DavidW-evoSonic/ESP32_ReflowOvenController/00081-01-L.jpg

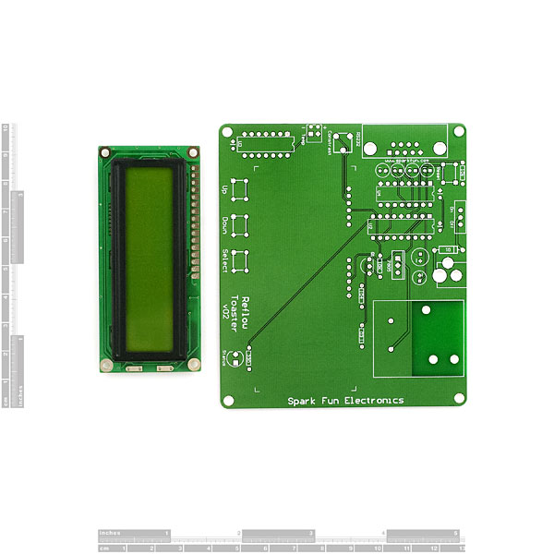
00081-01-L.jpg
