DavidW-evoSonic/ESP32_ReflowOvenController/00081-02-L.jpg

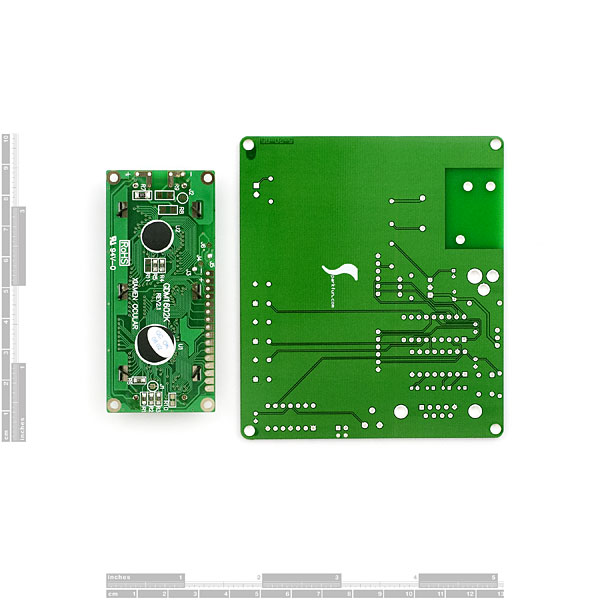
00081-02-L.jpg
