DavidW-evoSonic/ESP32_ReflowOvenController/00081-05-L.jpg

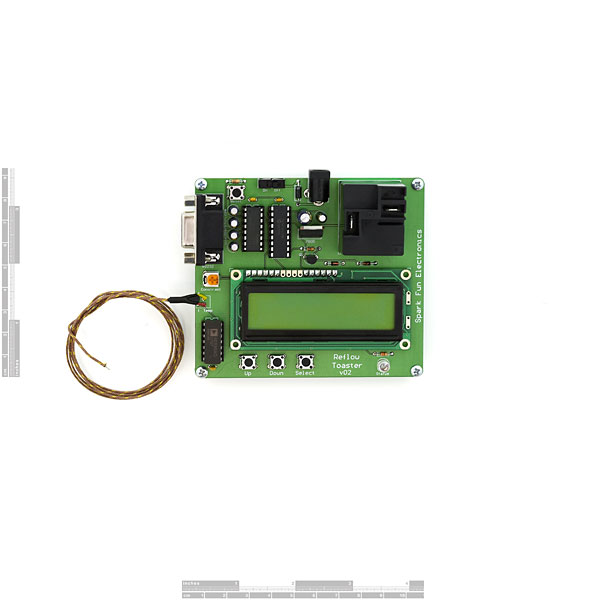
00081-05-L.jpg
