DavidW-evoSonic/ESP32_ReflowOvenController/(commit log)

2019-06-15 More Bug fixing and less agressive PID Tuning
    [ReflowController.ino]
2026-09-02 Replace phase-fired output stage with time-proportional relay control
    The reworked hardware has a mechanical relay and no zero-crossing detect
    input, so phase-angle firing is not possible. Removed the zero-cross ISR,
    the edge-timing/jitter validation in loop(), the one-shot scheduling in
    switchPower(), and the asin lookup table that linearised phase angle to
    power.
    In their place relayDriver() runs from a periodic esp_timer and expresses
    PID demand as on-time within a fixed 4s window, latched once per window so
    the on-pulse stays contiguous. Min on/off clamps round sub-500ms pulses
    away to fully off or fully on rather than cycling the contacts for them.
    HEATER1/HEATER2 collapse to a single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
    [ReflowController.ino]
2026-09-02 Read temperature from AD595 on ADC1 instead of MAX31855 over SPI
    The reworked hardware has an AD595 (10 mV/degC) on an analog pin rather
    than a MAX31855 on SPI. readTemperature() oversamples ADC1 64x to knock
    down the ESP32's sample noise and converts via esp_adc_cal, so the result
    uses the chip's factory eFuse calibration rather than a nominal full
    scale. Channel 6 (GPIO34) is input-only, and on ADC1 because ADC2 is
    unusable while WiFi is up.
    The signal is divided 1.5:1 in hardware before reaching the pin. The ADC
    is specified linear only to ~2450mV, so undivided, 250degC (2.50V at
    10mV/degC) would sit against the ceiling, compressed and reading low --
    the unsafe direction, since the PID w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
    [ReflowController.ino]
2026-09-02 Strip the display UI and drive the oven headlessly
    The reworked hardware has no TFT and no rotary encoder, so the display
    stack goes: Adafruit_GFX/ST7735, the menu engine and its whole MenuItem
    table, the on-screen keyboard, ClickEncoder, and every render path
    (renderMenuItem, updateProcessDisplay, splashscreen, memoryFeedbackScreen,
    displayMenusInfos). The RGB LED and buzzer stay -- they are local
    feedback rather than display, and on an oven with no screen they are the
    only indication you get without a browser.
    currentState was doing two jobs, mixing menu states with process states.
    Idle/Settings/Edit are replaced by Ready and Manual, and UIMenuEnd is
    renamed ProcessStart to say what the c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
    [ReflowController.ino]
2026-09-02 Provision WiFi through WiFiManager instead of the encoder
    Provisioning was an encoder-driven network scan with an on-screen
    keyboard, which the display rework left unreachable. WiFiManager raises
    its own access point when it has no working credentials, so the oven is
    set up from a phone through the captive portal instead.
    The portal is given a 180s timeout rather than being left open
    indefinitely: with no display there is nothing to show that the oven is
    sitting in the portal, and loop() has a relay and a sensor to service.
    Since there is no longer any local input, factoryReset also drops the
    WiFi credentials -- otherwise moving the oven to a different network
    would leave no way back to th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
    [ReflowController.ino]
2026-09-02 Surface profile, PID and autotune settings to the web UI
    Profile slots, profile fields, PID gains and the autotune parameters were
    all edited through the rotary-encoder menu, so the display rework left
    them with no way in. They are now readable at /profiles and /config and
    writable through /profile/edit, /pid and /tuning, with a settings panel
    in the browser UI covering the slot picker, the profile fields, PID, the
    autotune parameters, manual heating and factory reset.
    Editing follows the menu's old semantics: /profile/edit changes only the
    in-memory profile, and nothing is persisted until a slot is chosen via
    /profile/save. Mutations are refused with 409 unless the oven is idle.
    Writes ap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
    [ReflowController.ino]
2026-09-02 Replace PID with rate-corridor control
    The PID gains were never right for this hardware -- Kp 0.60 / Ki 0.01 /
    Kd 19.70 were tuned against a continuously-variable phase-fired SSR and the
    actuator is now a mechanical relay -- and they had never controlled anything on
    this branch. The rate-corridor law from the earlier C# controller had, on this
    oven, this relay and this probe. So the unproven component was PID, not the
    corridor law, and the swap removes an unknown rather than adding one.
    A profile is now a list of steps, each "reach targetTemp in between minDuration
    and maxDuration seconds". That pair is a corridor rather than a setpoint, and
    the controller nudges a discrete power level by o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
    [ReflowController.ino]
2026-09-02 Hold the relay off unless the control loop is alive
    relayDriver() runs from an esp_timer so it keeps servicing the relay when
    loop() blocks, which REWORK_NOTES sold as a feature. It is also the failure
    mode: loop() is the only thing that ever *lowers* powerHeater, so a stall in
    the web server or the WiFi stack leaves the timer driving the element at the
    last demand for as long as the board stays powered. On a mains heater that is
    the one bug that does not end with a wasted board.
    The control loop now stamps a heartbeat every 100 ms and relayDriver() refuses
    to close the relay without a fresh one. Two thresholds, because a transient
    stall and a dead loop() want different answers: stale by 5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
    [ReflowController.ino]
2026-09-02 Fix the temperature acquisition path for hum and resolution
    Two defects in readTemperature(), both of which mattered little under PID and
    matter a lot now that the controller steers a projection. The rate term is a
    difference of two rolling averages, and the projection multiplies it by the
    thermal lag before comparing it to a step target, so anything that corrupts the
    reading is amplified ten- or twentyfold into a decision about when to stop
    driving the element.
    Mains hum was passing through essentially unattenuated. The 64 oversamples were
    taken back to back, spanning about a millisecond -- a twentieth of a 50 Hz
    cycle -- so every sample landed on the same part of the sine wave and the
    ave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
    [ReflowController.ino]
2026-09-02 Defer the door prompt to the peak, and lock out a warm start
    Two ways the firmware could behave exactly as designed and still produce an
    unacceptable board.
    The door-open prompt fired before the peak. A heating step ends when arrival is
    *projected*, which is deliberately while the oven is still climbing and short
    of target -- the stored heat delivers the rest. Entering the next step is what
    beeped, so the firmware asked for the door at the exact moment the coast was
    doing the work of reaching peak temperature. Simulated, the prompt fired at
    236.6 degC with the 243.7 degC peak still 9 s away: an operator standing ready
    took 7 degC off the peak and shortened time above liquidus, with a perfec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
    [ReflowController.ino]
2026-09-02 Let each step choose whether its bounds are durations or rates
    Corridors rebase on the measured temperature at step entry, so a step whose
    bounds are durations covers less ground when the chamber starts warm while
    still taking its allotted time -- the ramp flattens, and spends longer drying
    the flux out before the board reaches liquidus. No fault, and a log that looks
    perfect. Locking out a warm start bounded that; it did not fix it.
    Steps now carry a BOUND_RATE flag and may state their pair as degC/s instead
    of seconds, with deriveStepDurations() converting via the distance the step
    actually has to cover. Which invariant is correct genuinely differs by step,
    which is why it is per-step rat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
    [ReflowController.ino]
2026-09-02 Pre-flash fixes: heater on GPIO 16, temperature filters primed
    Two things found on a last read-through before the firmware meets an oven.
    The heater pin is decided. 16 is one of the two original heater pins and so is
    already routed for heater duty on the board, which makes it the obvious choice;
    17 stays free as the alternative. The define is no longer a placeholder and the
    TODO goes with it, taking the relay GPIO off the blocker list in REWORK_NOTES
    section 1 -- two remain, the divider and the board type.
    Two hardware assumptions ride on that pin, neither of which the firmware can
    check for itself. GPIO 16 and 17 are the PSRAM interface on WROVER modules, so
    this assumes a plain WROOM, as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
    [ReflowController.ino]
2026-09-03 Initialise the LEDC buzzer channel, not just its timer
    ledcSetup(0,1000,0) passed 0 as duty resolution, which is out of range, so
    it configured nothing. ledcSetup only sets up the timer in any case, leaving
    ledcAttachPin to read back an unconfigured channel.
    [ReflowController.ino]
2026-09-03 Show live temperature, target and heater state above the graph
    The heater tile reports the relay contact, not the demand: the two differ
    whenever a fault or a stale heartbeat holds the relay off, and constantly
    during normal running.
    Target blanks when idle, because the Ready state parks the setpoint on the
    current temperature, which is not an intention the oven has. The readout
    greys out on a failed poll rather than showing a stale number confidently.
    [ReflowController.ino]
2026-09-03 Apply the step's fast rate bound in every corridor branch
    It lived in the inside-the-corridor arm, which is unreachable once elapsed
    time passes maxDuration: behindFrac clamps to 1.0, so a step short of target
    is permanently behind and takes the first branch instead.
    [ReflowController.ino]
2026-09-03 Leave Running when a fault latches
    reportError() cannot touch currentState -- relayDriver() calls it from the
    esp_timer task. So a faulted run marched its remaining steps and finished
    with the single beep a good run gives.
2026-09-03 Extend a heating step that is still climbing
    A step short of target at its slow bound used to advance regardless, and
    faulted only past STEP_MISS_C -- so a 14 degC miss vanished, rebased into
    the next step. It now keeps running until it reaches target, with its rate
    bounds still in force and only its duration watchdog suspended.
    Bounded three ways: entry only within STEP_MISS_C, so the dead-element
    fault keeps its timing; 45 s per step; and 25 s of above-liquidus time per
    run, which is what the 60-90 s paste spec leaves once the default profile
    has spent 61.8 s there.
    [ReflowController.ino]
2026-09-03 Add password-protected OTA with a mid-reflow lockout
    The default partition table already carried app1 and otadata, so no
    repartition: 12.3 KB of app0, leaving 342 KB free.
    Both gates run in the upload callback, not the completion handler -- that
    callback writes flash as it goes, so a check deferred to completion would
    refuse the request after the running firmware had been overwritten. The
    state gate names Ready and Complete rather than excluding busy ones,
    because Manual drives the heater yet sits below ProcessStart.
    Refused outright until a password is set. The relay heartbeat is left to go
    stale during an upload, which holds the contact open.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
2026-09-03 Refuse GPIO 23 and friends as the heater pin at compile time
    23 is tied directly to 3V3 on this PCB, so driving it low shorts the pad's
    low-side driver across the rail. The trap is the direction: LOW is the safe
    heater state, written by setup() and reportError(), so the short would land
    exactly when the firmware was making the oven safe. It was listed as a free
    pin to move the heater to; it no longer is.
    Also refused: 6-11 (flash bus), 12 (straps VDD_SDIO to 1.8V and the module
    will not boot), 34-39 (input-only, so pinMode(OUTPUT) does nothing).
    [ReflowController.ino]
2026-09-03 Fault in 50 s when heat is demanded and nothing happens
    The only dead-element check fired at maxDuration, which on the default
    rate-bounded step 0 is 130/0.72 = 181 s. Three minutes of a commanded-on
    mains relay before anyone is told, for the most likely fault in the machine.
    While a heating step demands at least half power, the oven must rise 2 degC
    per 30 s window. The default profile's own slow bound is 0.72 degC/s, i.e.
    21 degC in that window, so there is 10x slack against the readout's sub-0.1
    degC noise over the same span.
    Gated on demand rather than on measured rise alone: a step legitimately sits
    flat once it is at temperature, since the approach clamp cuts power and a
    dwell holds.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
    [ReflowController.ino]
2026-09-03 Integrate on 8 s, but cut immediately, and start at full duty
    The level was re-evaluated once per 4 s relay window. The actuator can
    express a change that fast; the oven cannot show it. With a thermal lag
    around 20 s the loop decided four or five times before the first decision
    reached the thermometer, so it chased its own dead time.
    Now counted in whole relay windows off a counter relayDriver() increments
    at each latch. That also fixes a phase bug: lastLevelUpdate_ms was reset at
    step entry while the relay window was not, so a change landing mid-window
    was deferred to the next latch and the effective period jittered between
    one and two windows.
    2 windows, not more, because the peak step i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
    [ReflowController.ino]
2026-09-03 Fix the temperature labels on the chart
    "Temperatur" was the original author's German, and it showed in the legend
    and every tooltip. The left axis said "Temps", which is French for time on
    a chart whose other axis is Time (s) -- a mislabelled duplicate rather than
    a misspelling. The CSV export header is hand-written rather than derived
    from the column, so it needed the same fix or the export would disagree
    with the chart.
2026-09-03 Sound an audible door alarm in the browser
    No buzzer is fitted, so the peak banner was the only door prompt.
    Adds a warbling Web Audio beep and a flashing tab title, with a
    Silence button that leaves both visual cues running.
2026-09-03 Anchor an upward step's corridor at the profile's target
    stepStartTemp rebased on the measured temperature, so progress read
    0.0 and on-schedule while the oven sat below the profile. STEP_MISS_C
    checks each step against its own target only, so the shortfalls added
    across heating steps with no fault raised.
    The comment on defaultSteps already documented the anchored
    behaviour; only the code disagreed.
    [ReflowController.ino]
2026-09-03 Keep charting the cooling curve past Complete
    Recording stopped the moment the state changed, discarding the ramp
    down entirely on a fault. Samples on to 50 degC or 15 min, with the
    setpoint and corridor series nulled since the firmware parks them on
    the present temperature once idle.
2026-09-03 Show the controller's own die temperature
    The electronics sit in an enclosure inside the oven, a sheet of metal
    from the element, and nothing aboard reported on them. Samples
    temperatureRead() every 2 s, publishes it in /status and adds an
    Electronics tile that goes amber at 70 degC and red at 85, the
    WROOM-32 module's rated maximum.
    Readout only: it never gates a start and never latches a fault. The
    sensor is an undocumented librtc.a function sharing hardware with the
    RF calibration, and its uint8_t Fahrenheit scale pegs at 123.9 degC,
    which the tile shows as pegged rather than as a reading.
2026-09-03 Stop the control loop over-correcting on rate noise
    Three fixes to one symptom: power cut hard, then a long climb back.
    The rate the law steers on was a 1 s difference. Measured against a
    constant 0.88 degC/s it had sigma 0.48 and reached 2.40, and three
    decisions read it -- the approach clamp, the fast-bound ceiling and
    the in-corridor rate check. controlRamp differences across a whole
    relay window instead: sigma 0.30, and partial duty can no longer
    alias into the rate. The 1 s value stays for display.
    PROJECTION_MAX_RATE_C_S 5.0 -> 2.0. Measured extremes are 0.88
    heating and 1.62 cooling, so 5.0 clamped nothing real while letting a
    spike project +25 degC at a 5 s lag.
    Heating steps now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
    [ReflowController.ino]
2026-09-03 Wait for an oven that is still climbing, and stop misdiagnosing it
    "Oven not heating" was reported about an oven rising at 0.27 degC/s.
    Short of target and not heating are different claims and the message
    asserted the second from evidence for only the first, sending the
    operator to look at the element.
    Two gates were rejecting a genuinely climbing step. The extension
    entry gate required the miss to be within 15 degC, which does not
    identify a dead element -- the gain test does, and HEAT_STALL_WINDOW_MS
    already catches one in 30 s regardless of step timing. And the gain
    floor scaled with the rate the step demanded, which is the wrong
    question once a step is known to be short. Both removed; e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
    [ReflowController.ino]
2026-09-03 Hold the peak, and bring it down to 240
    The peak was a triangular apex: one 243 degC step straight into the
    descent, so the oven touched it and turned around. With the probe in
    the air the board lags the reading in both magnitude and time, which
    is the worst case for a peak that is only touched -- the 2026-09-03
    run ended at 221 degC of air with the solder unmelted.
    Adds a 15 s dwell at peak and lowers the peak to 240. Time above
    liquidus goes from 45.2-61.8 s to 60.2-76.8 s, so the fast end now
    meets the 60 s minimum it used to miss. RUN_EXTEND_LIQ_S 25 -> 12 to
    keep a fully extended run at 88.8 s.
    Two supporting fixes, or the dwell would not be one: a step repeating
    the previous target n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
    [ReflowController.ino]
2026-09-03 Make a step advance on the thermometer when the next step is hotter
    Both preheat steps ended short -- 170 left at 164.5 and 220 at 213.1
    -- so the board soaked at neither target and the peak ramp began 7 degC
    down. The projection's early cut was doing it.
    That cut exists to stop the oven overshooting a target it must not
    exceed, which is not the case for a step leading into a hotter one:
    there, overshoot is progress and cutting early only hands the
    shortfall forward. Those steps now advance on the measured
    temperature; the peak and every descent keep the projection.
    Replayed against the run: step 1 grows 160 -> 168 s against a 154-201
    window, step 2 is unchanged at 48 s, and step 2 starts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
    [ReflowController.ino]
2026-09-03 Hold the peak for 30 s, and give the loop 9 power levels
    The 15 s dwell left time above liquidus at 47.4 s, under the 60 s
    minimum. Sizing it by summing declared durations predicted 76.8 s and
    was wrong twice over -- the 220 step never crossed 217 at all, and the
    door takes the descent through it in 11 s of a 21-28 s step. The
    dwell is the only deterministic contribution, so it is the lever: a
    35.6 s measured base plus 30 s lands near 65 s.
    POWER_LEVELS 5 -> 9 for the step-1 limit cycle: 100% to 0 over 48 s
    and back over 32 s, because a pure integrator with 25% jumps cannot
    sit still when the oven does 2.1 degC/s at 50 degC and 0.88 at 200
    against one declared bound. 12.5% of a 4 s window i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
    [ReflowController.ino]
2026-09-03 Stamp the build, and show it in the interface
    Asked "is the latest version on the oven", the answer was that it could
    not be determined. The running profile could be dated from its step
    values, but the code could not be dated at all: both 2026-09-04 commits
    changed only control logic, so every /status and /config field was
    byte-identical before and after. There was nothing version-shaped
    anywhere in the API.
    FW_VERSION starts at 2.0.1 and is the deliberate half -- bump it when
    flashing something worth distinguishing. FW_BUILD is the honest half.
    A hand-maintained number fails exactly the way the profile just did,
    by depending on someone remembering; __DATE__/__TIME__ move on every
    rebuild r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
    [ReflowController.ino]
2026-09-03 Stop calling a slow cooldown a welded relay
    A run that completed normally ended in "Temperature is Way to HOT!!!!!"
    with the relay open, the element cold and the oven falling at
    1.8 degC/s. The corridor abort had fired.
    Its comment claimed a gap this large meant a welded contact "and
    nothing else does". On a cooling step nothing of the sort follows. That
    corridor is a timer -- the note at defaultSteps already says a cooling
    step's declared duration says nothing about where the temperature is --
    and the last step drives it from 150 to 30 degC in 20-30 s while the
    oven coasts down far slower. The gap opens past 100 degC on a healthy
    oven every run. A board-mounted probe widens it further, a b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
2026-09-03 Drop the power-cycle advice from the fault banner
    It was appended to every fault regardless of cause, so it said nothing
    about the one the operator actually had, and a reboot does not fix any
    of the conditions that raise one -- not a welded contact, not a dead
    element, not an open thermocouple.
    Worth recording what it was standing in for, because removing the text
    does not remove the constraint. globalError is set in reportError() and
    cleared nowhere, so a fault locks out /start until the oven reboots.
    The advice was unhelpful but it was describing something real.
    Giving faults a clear path is a change to the safety model rather than
    to the UI -- it would let an operator dismiss a fault an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
2026-09-03 Add a Hold state for comparing the probe against a meter
    Characterising the temperature probe means parking the oven at several
    levels and reading it against a reference instrument at each. Nothing
    here could do that: a profile run never stops, and /manual holds a
    fixed POWER, which drifts.
    /hold?temp=N regulates to a fixed temperature until stopped, and is
    accepted from Hold as well as Ready so a sweep can step between levels
    without stopping and re-entering from a cold chamber. It is
    deliberately not gated on PROFILE_START_MAX_C: that limit exists
    because a profile must not start with stored heat it has not accounted
    for and because loading a board means reaching into the oven, and
    neithe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
    [ReflowController.ino]
2026-09-03 Release 2.1.0, and write down what the numbers mean
    Since 2.0.1: two fault-message corrections and the Hold state. The
    fixes alone would have been a patch, but /hold is a new route and a new
    state, so it is a minor. Nothing that existed before behaves
    differently for a caller that was already using it.
    The policy now sits next to the define rather than in whoever's head
    last bumped it, because the major is meant to be expensive and that
    only holds if what earns one is written down. Breaking a caller or
    changing the safety model earns it; adding a JSON field does not.
    Also recorded there: a profile saved to a slot survives a flash
    whenever sizeof(Profile_t) is unchanged, so a release that e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
    [ReflowController.ino]
2026-09-04 Release 2.2.0: make the hold gains settable at runtime
    They are #defines, so tuning them cost a rebuild and a flash per
    iteration, on a controller sitting across the room with a hot oven
    attached. That is enough friction to stop the tuning happening at all.
    /oven?holdPBand=&holdTrim= now sets both, persisted alongside the
    thermal lag and reported by /config. They are the only gains in this
    firmware -- the corridor law still has none, and this does not change
    that.
    holdTrim=0 is explicitly allowed rather than clamped to a minimum,
    because proportional-only is the useful diagnostic: with no integrator
    the regulator parks below setpoint by exactly the power the equilibrium
    needs, so the droop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
2026-09-04 Correct the probe reading, and let the end user recalibrate it
    readTemperature() returned mv*ratio/10 and called it degrees. Measured
    against a K-type handheld it reads high by 6-8 degC across the reflow
    range, so every target in every profile has been about 7 degC optimistic.
    The correction is a quadratic, true = c2*raw^2 + c1*raw + c0, because
    the response is not straight. That only shows at the top: a line
    through the five points below 145 degC fitted them to +-0.03 degC and
    predicted the 226 degC point 3.6 degC wrong. Suspect the AD595, which
    linearises the K-type curve at a fixed 10 mV/degC that is exact only
    near its design point. Six points, 25-226 degC, residuals +-0.38.
    Data and me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
    [ReflowController.ino]
2026-09-04 Release 2.4.0: warn on a slow heat instead of ending the run
    Step 0 came up 3 degC short of 170 on 2026-09-04 and the firmware
    stopped the run. The board was left with the paste half soaked, and
    because globalError latches there was no way to restart without a power
    cycle -- by which time the chamber was too hot to pass the start gate
    anyway. A recoverable board became a lost one.
    Stopping only helps when stopping helps. Nobody can replace a heater
    with a board in the chamber, so a slow heat is not actionable mid-run:
    aborting turns "this might still be a good board" into "this is
    definitely a ruined board". These four now warn and carry on:
    Extended step never reached target
    Extended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
    [ReflowController.ino]
2026-09-04 Release 2.5.0: a heating step ends on its target, not on a clock
    Removes the extension budget -- 45 s per step, 60 s per run, 12 s of
    that above liquidus -- and with it the idea that there is a time limit
    on reaching a temperature.
    A budget answers "how long am I allowed to keep trying", and nothing
    useful turns on the answer. The operator cannot replace a heater with a
    board in the chamber, so a step that runs out of budget hands forward a
    shortfall nobody can act on: every downstream step starts cold and the
    peak arrives short. On 2026-09-04 a step ended 3 degC below a 170 degC
    target with the paste half soaked.
    The question worth asking is physical and was already being computed:
    is the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
    [ReflowController.ino]
2026-09-04 Release 2.6.0: stop the approach clamp stalling a step that leads into a hotter one
    The 2026-09-04 run reflowed, but spent over a hundred seconds with the
    element off making no progress: 57 s parked a degree under 170 and 45 s
    parked a degree under 220. The header read "+58s extended".
    Two rules were fighting and the clamp was winning. A step whose next
    step is hotter advances on the MEASUREMENT, deliberately -- overshoot
    there is progress toward the next target, and cutting early hands the
    shortfall forward. But the approach clamp still zeroed the power on the
    PROJECTION. At 169.5 degC with a 20 s lag, any climb above 0.025 degC/s
    makes projectedTemp >= 170 true, so the clamp re-fired ever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
    [ReflowController.ino]
2026-09-04 Release 2.7.0: give the profile a soak
    The first clean run reflowed, but the largest components went last and
    the board read cooler than the probe. Neither is a heat shortage -- it
    spent roughly 120 s above liquidus against a 60-90 s spec and the heavy
    parts still only just made it. It is a gradient. A part tied to a
    ground plane carries far more mass than the laminate the probe sits on,
    so it lags, and the profile gave it nowhere to catch up: 25 to 170 to
    220 to 245 with no plateau anywhere.
    Time closes a thermal gradient; temperature does not. Raising the peak
    again would cook the light parts and still leave the heavy ones behind.
    The soak has to sit BELOW liquidus or it is not a soak, a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
    [ReflowController.ino]
2026-09-04 Add a heating-rate analyser
    Full-power degC/s per temperature band, from an ovenlog.sh CSV, and the
    minimum seconds a 200->245 ramp therefore needs.
    The profile's ramp windows are rates in disguise -- 45 degC in 55-90 s
    is a demand for 0.50-0.82 degC/s -- and demanding more than the element
    can produce means every peak arrives on the give-up path instead of on
    its target. Those windows were sized on 0.88 degC/s at 200, measured
    before the door was insulated, so they need re-deriving rather than
    guessing whenever the chamber changes.
    Counts only samples at >=95% duty, so a regulator easing off near a
    setpoint is not mistaken for the oven running out of steam.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
2026-09-04 Release 2.8.0: retune the peak ramp to the insulated oven
    Measured after the door was insulated: 2.2 degC/s sustained at full
    power through 196-217 degC, against the 0.88 at 200 that every ramp
    window in this profile was derived from. The insulation roughly doubled
    the high-end rate.
    So the peak ramp's 55-90 s was demanding 0.50-0.82 degC/s of an element
    that can now deliver four times that. A corridor that asks for less
    than the oven can give does not merely waste time -- it holds the board
    above liquidus while it throttles, which is the exposure the profile
    exists to minimise. 20-45 s asks 1.00-2.25 degC/s, inside both the
    measured capability and the 1-3 degC/s that a ramp to peak wants.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
2026-09-04 Drop the last dead variable from the extension budget
    miss_C survived the removal of the extension budget in 2.5.0 -- nothing
    reads it now that a heating step has no timeout. It was the only warning
    in the build, and a build with one warning trains you to ignore warnings.
2026-09-04 Release 2.9.0: keep the last run on the oven
    The firmware kept no run history. A run existed in two places, both
    fragile: the chart in whichever browser tab happened to be open, and an
    ovenlog.sh CSV if anyone remembered to start one before pressing Start.
    Neither survives a closed tab or a forgotten logger, and a run that
    cannot be re-read afterwards cannot be tuned against.
    So sample once a second into a fixed RAM buffer and serve it as CSV from
    GET /history -- the same columns ovenlog.sh writes, so tools/heatrate.py
    reads it unchanged.
    A true ring rather than fill-and-stop. Since 2.5.0 a heating step has no
    time limit, so a slow run can outlast any fixed buffer; when something
    has to be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
    [ReflowController.ino]
2026-09-04 Stop heatrate.py deleting the fast bands it exists to measure
    Three faults, all of which made the oven look slower than it is.
    The evidence filter counted SECONDS in a band. Seconds in a band fall as
    the rate rises, so it discarded exactly the fast bands the tool is for:
    at 1.7 degC/s a 5 degC band is crossed in 3 s and was dropped, while a
    sluggish band lingered and survived. A loaded run that reached 241 degC
    reported nothing above 70. Evidence is now a count of samples.
    crossing_time latched its start clock and then returned at the first
    sample above the target without checking what happened in between, so
    coasting counted as full-power capability -- it reported '200 -> 240 at
    full powe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
2026-09-04 Release 2.10.0: size the descent to what the oven actually does
    The three cooling steps allowed about 100 s between them to describe a
    descent that measured 450 s and had not finished. All three timed out, so
    the corridor plunged 245 -> 30 degC while the board sat at 212, the
    target dived away from the trace instead of following it, and the run
    declared Complete at 212 degC -- five degrees after the board stopped
    being molten.
    Measured on the 2026-09-04 pasted run from a 248.2 peak with the door
    opened at the prompt: 0.59 degC/s at 210-230 falling to 0.19 at 70-90.
    The new durations are those numbers, so each cooling step now ends on the
    thermometer rather than on its watchdog.
    The slope c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
2026-09-04 Release 2.11.0: drop the soak to 180 to give the ramp runway
    The 200 soak reflowed -- heavy parts came up together, paste stayed
    liquid visibly longer -- but cost 141 s above liquidus against a 60-90 s
    spec, and the trace says most of that was crawling rather than soaking.
    A 200 soak on this oven is a coast, not a regulated hold. Mean duty
    across the 59 s soak was 1.7%: the oven arrived on the previous step's
    stored heat, drifted to 208.3 unbidden, and sat with the element dead.
    Step 3 then asked full power of cold iron and got 0.19 degC/s for fifteen
    seconds, levelling at ~0.65 -- against 1.88 from the same oven at the
    same temperature with the element saturated. Step 3 hit its ceiling at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
    [ReflowController.ino]
2026-09-04 Release 2.12.0: wait out the reboot after an OTA and reload
    After a successful upload the page just printed the server's reply and
    sat there. Everything on it was stale from that moment -- the status poll
    was talking to a board that had already restarted -- and the only way
    back was to reload by hand, without knowing when the oven would answer.
    Now a successful upload covers the page and reloads it as soon as the
    oven is back.
    Polled rather than a fixed timer. A restart is nominally ~10 s but it is
    not a constant, and WiFi association is the slow and variable part: a
    fixed wait either reloads into a host that is still down or sits there
    long after the oven is ready. Reloading on the first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
    [ReflowController.ino]
2026-09-04 Close the repo root to images so no screenshot can be checked in
    A screenshot of the oven page carries the LAN address in the browser
    address bar, and the trace on it is oven-specific information that does
    not leave this machine -- the same class of thing the 2026-09-04 history
    purge removed.
    The earlier pattern only caught Screenshot*.png. Screenshot tools do not
    agree on a naming convention, so rather than guessing them all, the repo
    root is closed to images outright: that is where screenshot tools drop
    their output, and no source file in this project is an image.
    Already-tracked images are untouched -- .gitignore does not apply to a
    tracked file -- so images/ and the existing root photo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
